lhr-solar/PS-VehicleControlUnit/Hardware/VehicleControlUnitLib/436500428.stp

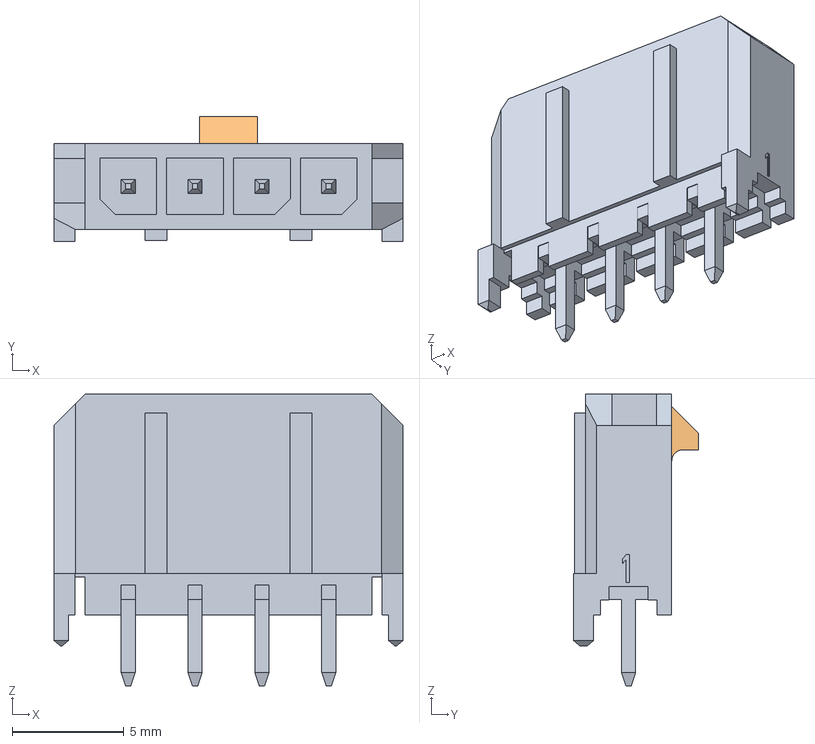
[picture p2: CAD file, 2025-09-12]
Hardware/VehicleControlUnitLib/436500428.stp
15.7 x 5.61 x 13.1 mm
