lhr-solar/PS-VehicleControlUnit/Hardware/VehicleControlUnitLib/436500227.stp

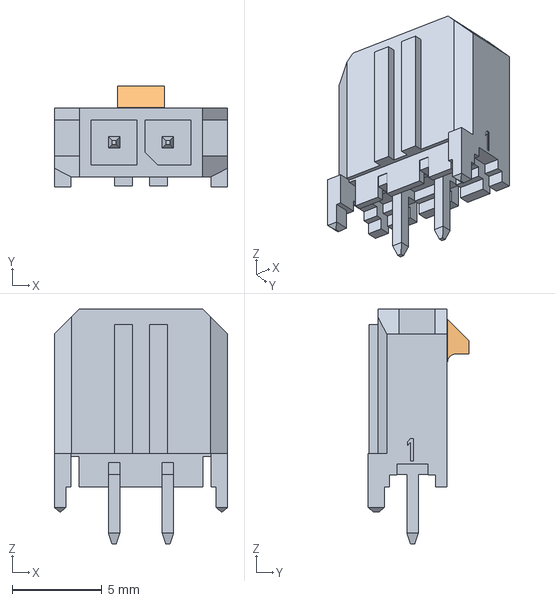
[picture p3: CAD file, 2025-09-12]
Hardware/VehicleControlUnitLib/436500227.stp
9.65 x 5.61 x 13.1 mm
