lhr-solar/PS-VehicleControlUnit/Hardware/ActivePrecharge.kicad_sch

## KiCad design Hardware/ActivePrecharge.kicad_sch (2025-09-12)

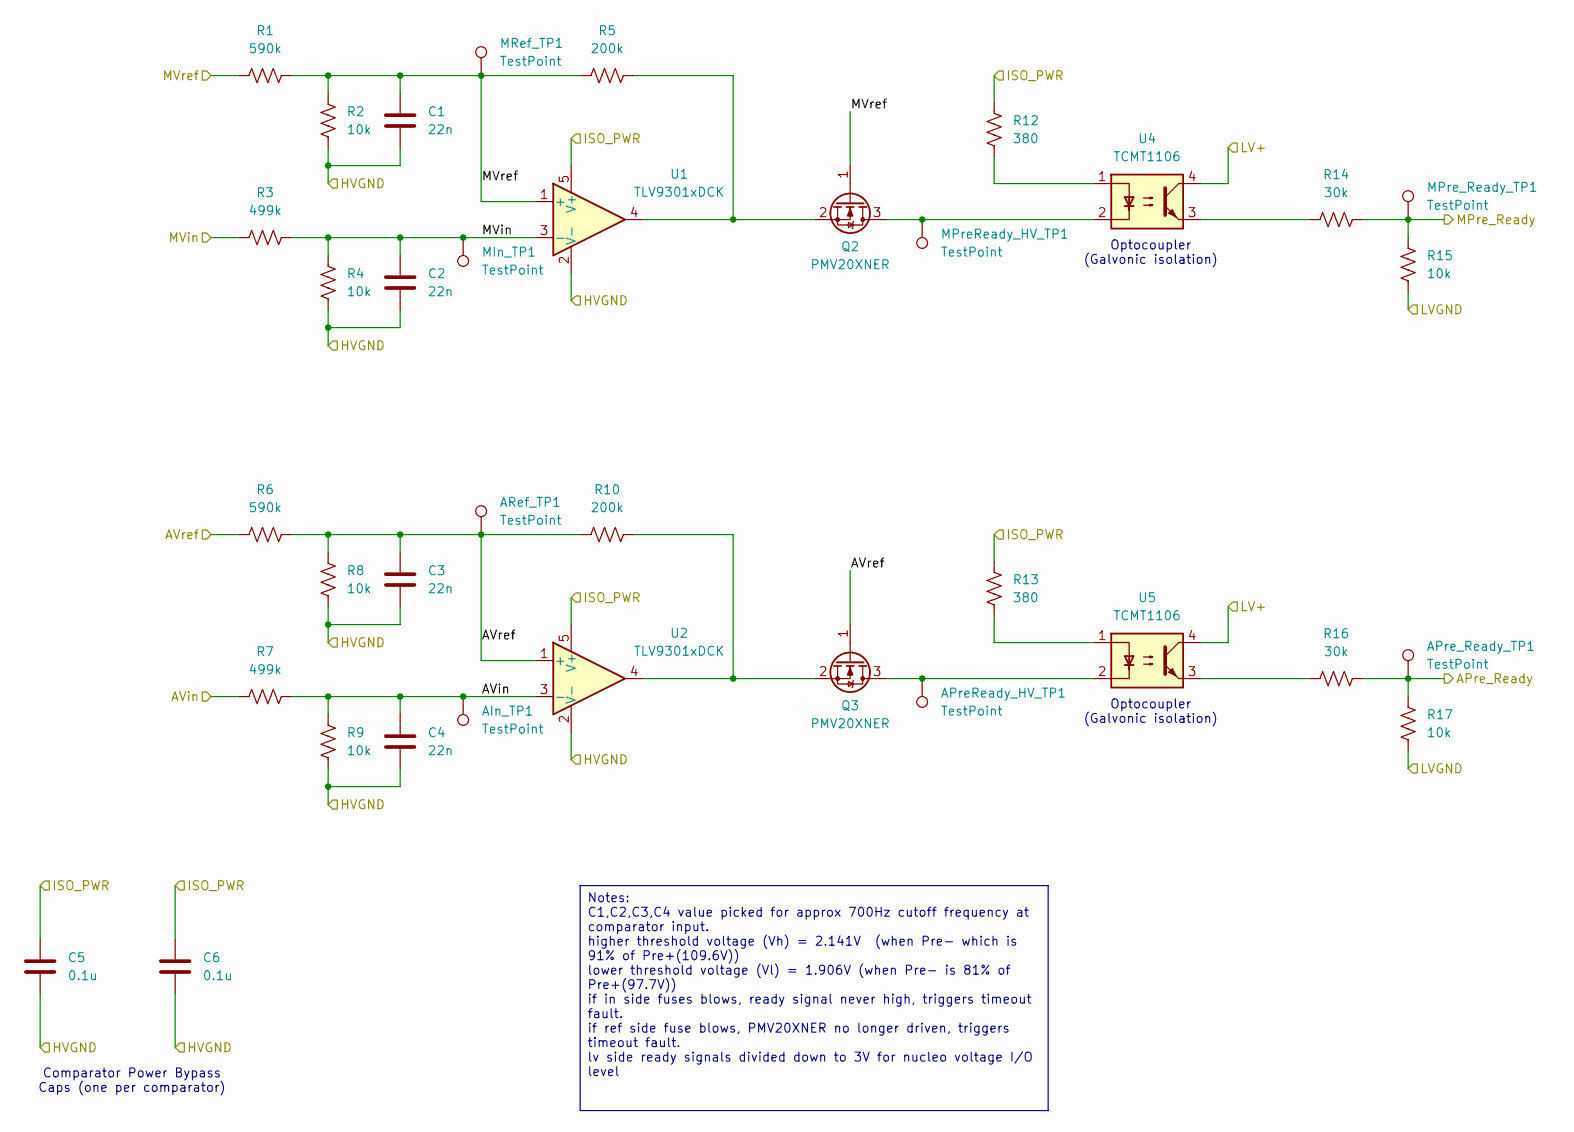
[picture p4: schematic ActivePrecharge.kicad_sch]

Parts:
AIn_TP1: TestPoint
APreReady_HV_TP1: TestPoint
APre_Ready_TP1: TestPoint; TestPoint_HEX_3mmID
ARef_TP1: TestPoint
C1, C2, C3, C4: 22n
C5, C6: 0.1u
MIn_TP1: TestPoint
MPreReady_HV_TP1: TestPoint
MPre_Ready_TP1: TestPoint; TestPoint_HEX_3mmID
MRef_TP1: TestPoint
Q2, Q3: PMV20XNER; SOT-23
R1, R6: 590k
R2, R4, R8, R9: 10k
R3, R7: 499k
R5, R10: 200k
R12, R13: 380; R_0805_2012Metric
R14, R16: 30k; R_0805_2012Metric
R15, R17: 10k; R_0805_2012Metric
U1, U2: TLV9301xDCK; SOT-353_SC-70-5
U4, U5: TCMT1106; SOP-4_4.4x2.6mm_P1.27mm

Connections:
APre_Ready: APre_Ready_TP1.1, R16.2, R17.1
AVin: AIn_TP1.1, C4.1, R7.1, R7.2, R9.2, U2.3 (-)
AVref: ARef_TP1.1, C3.1, Q3.1 (G), R6.1, R6.2, R8.2, R10.2, U2.1 (+)
HVGND: C1.2, C2.2, C3.2, C4.2, C5.2, C6.2, R2.1, R4.1, R8.1, R9.1, U1.2 (V-), U2.2 (V-)
ISO_PWR: C5.1, C6.1, R12.2, R13.2, U1.5 (V+), U2.5 (V+)
LV+: U4.4, U5.4
LVGND: R15.2, R17.2
MPre_Ready: MPre_Ready_TP1.1, R14.2, R15.1
MVin: C2.1, MIn_TP1.1, R3.1, R3.2, R4.2, U1.3 (-)
MVref: C1.1, MRef_TP1.1, Q2.1 (G), R1.1, R1.2, R2.2, R5.2, U1.1 (+)
unnamed: APreReady_HV_TP1.1, Q3.3 (D), U5.2
unnamed: MPreReady_HV_TP1.1, Q2.3 (D), U4.2
unnamed: Q2.2 (S), R5.1, U1.4
unnamed: Q3.2 (S), R10.1, U2.4
unnamed: R12.1, U4.1
unnamed: R13.1, U5.1
unnamed: R14.1, U4.3
unnamed: R16.1, U5.3

Notes on the sheet:
Optocoupler (Galvonic isolation)
Comparator Power Bypass Caps (one per comparator)
Notes: C1,C2,C3,C4 value picked for approx 700Hz cutoff frequency at comparator input. higher threshold voltage (Vh) = 2.141V (when Pre- which is 91% of Pre+(109.6V)) lower threshold voltage (Vl) = 1.906V (when Pre- is 81% of Pre+(97.7V)) if in side fuses blows, ready signal never high, triggers ti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
