lhr-solar/PS-VehicleControlUnit/Hardware/Buttond_LEDs_IO.kicad_sch

## KiCad design Hardware/Buttond_LEDs_IO.kicad_sch (2026-01-13)

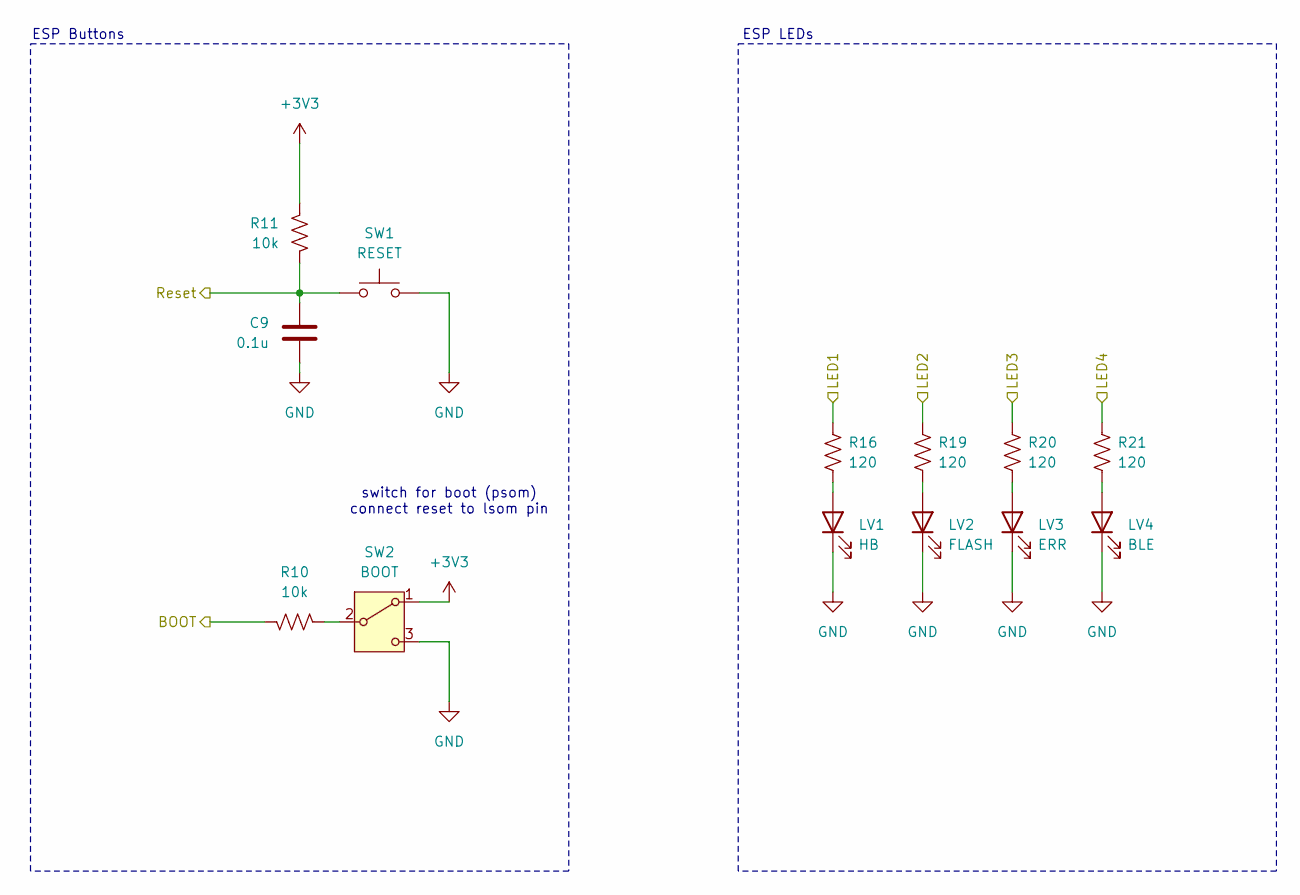
[picture p5: schematic Buttond_LEDs_IO.kicad_sch]

Parts:
C9: 0.1u; C_0603_1608Metric_Pad1.08x0.95mm_HandSolder; Mouser Part Number 963-HMK107B7104KA-T
LV1: HB; LED_0603_1608Metric_Pad1.05x0.95mm_HandSolder
LV2: FLASH; LED_0603_1608Metric_Pad1.05x0.95mm_HandSolder
LV3: ERR; LED_0603_1608Metric_Pad1.05x0.95mm_HandSolder
LV4: BLE; LED_0603_1608Metric_Pad1.05x0.95mm_HandSolder
R10, R11: 10k; R_0603_1608Metric_Pad0.98x0.95mm_HandSolder; Mouser Part Number 71-CRCW060310K0FKEI
R16, R19, R20, R21: 120; R_0603_1608Metric_Pad0.98x0.95mm_HandSolder; Mouser Part Number 71-CRCW0603120RFKEC
SW1: RESET; TL3365AF180QG; Mouser Part Number 667-EVQ-7Q203W
SW2: BOOT; SW_CJS-1200TA; Mouser Part Number 229-CJS-1200TA

Connections:
+3V3: R11.1, SW2.1 (A)
BOOT: R10.1
GND: C9.2, LV1.1 (K), LV2.1 (K), LV3.1 (K), LV4.1 (K), SW1.1 (A), SW1.2 (A), SW2.3 (C)
LED1: R16.1
LED2: R19.1
LED3: R20.1
LED4: R21.1
unnamed: LV1.2 (A), R16.2
unnamed: LV2.2 (A), R19.2
unnamed: LV3.2 (A), R20.2
unnamed: LV4.2 (A), R21.2
unnamed: R10.2, SW2.2 (B)
Reset: C9.1, R11.2, SW1.3 (B), SW1.4 (B)

Notes on the sheet:
switch for boot (psom) connect reset to lsom pin
ESP Buttons
ESP LEDs
