lhr-solar/PS-VehicleControlUnit/Hardware/CAN.kicad_sch

## KiCad design Hardware/CAN.kicad_sch (2025-09-12)

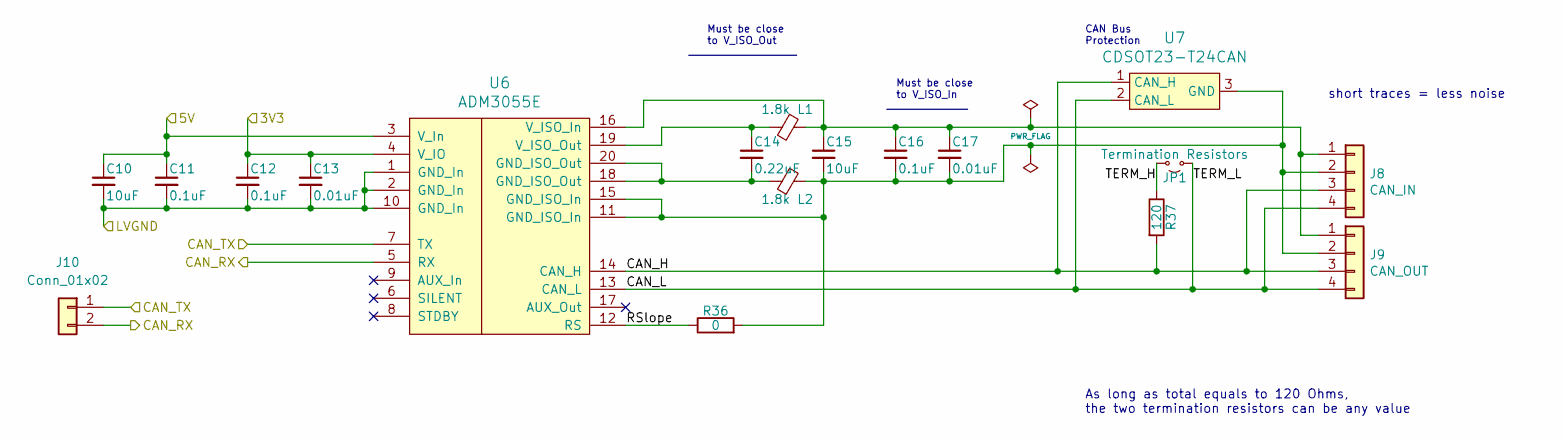
[picture p6: schematic CAN.kicad_sch]

Parts:
C10, C15: 10uF; C_0805_2012Metric; Mouser Part Number 963-TMK212BBJ106MGHT
C11, C12, C16: 0.1uF; C_0805_2012Metric; Mouser Part Number 80-C0805C104M5R
C13, C17: 0.01uF; C_0805_2012Metric
C14: 0.22uF; C_0805_2012Metric; Mouser Part Number 80-C0805C224J1RECTU
J8: CAN_IN; Molex_MicroFit3.0_1x4xP3.00mm_PolarizingPeg_Vertical
J9: CAN_OUT; Molex_MicroFit3.0_1x4xP3.00mm_PolarizingPeg_Vertical
J10: Conn_01x02; PinHeader_1x02_P2.54mm_Vertical
JP1: Termination Resistors; PinHeader_1x02_P2.54mm_Vertical
L1, L2: 1.8k; L_0805_2012Metric; Mouser Part Number 710-742792090
R36: 0; R_0805_2012Metric; Mouser Part Number 71-CRCW08050000Z0EAC
R37: 120; R_0805_2012Metric
U6: ADM3055E; SOIC-20W_7.5x15.4mm_Pitch1.27mm
U7: CDSOT23-T24CAN; SOT-23-3; Mouser Part Number 652-CDSOT23-T24CAN

Connections:
3V3: C12.1, C13.1, U6.4 (V_IO)
5V: C10.1, C11.1, U6.3 (V_In)
CAN_H: J8.3, J9.3, R37.2, U6.14 (CAN_H), U7.1 (CAN_H)
CAN_L: J8.4, J9.4, JP1.1 (A), U6.13 (CAN_L), U7.2 (CAN_L)
CAN_RX: J10.2, U6.5 (RX)
CAN_TX: J10.1, U6.7 (TX)
LVGND: C10.2, C11.2, C12.2, C13.2, U6.1 (GND_In), U6.2 (GND_In), U6.10 (GND_In)
unnamed: C14.1, L1.2, U6.19 (V_ISO_Out)
unnamed: C14.2, L2.2, U6.18 (GND_ISO_Out), U6.20 (GND_ISO_Out)
unnamed: C15.1, C16.1, C17.1, J8.1, J9.1, L1.1, U6.16 (V_ISO_In)
unnamed: C15.2, C16.2, C17.2, J8.2, J9.2, L2.1, R36.2, U6.11 (GND_ISO_In), U6.15 (GND_ISO_In), U7.3 (GND)
RSlope: R36.1, U6.12 (RS)
TERM_H: JP1.2 (B), R37.1

Notes on the sheet:
As long as total equals to 120 Ohms, the two termination resistors can be any value
short traces = less noise
Must be close to V_ISO_Out
Must be close to V_ISO_In
CAN Bus Protection
