lhr-solar/PS-VehicleControlUnit/Hardware/ContactorDriver.kicad_sch

## KiCad design Hardware/ContactorDriver.kicad_sch (2026-01-13)

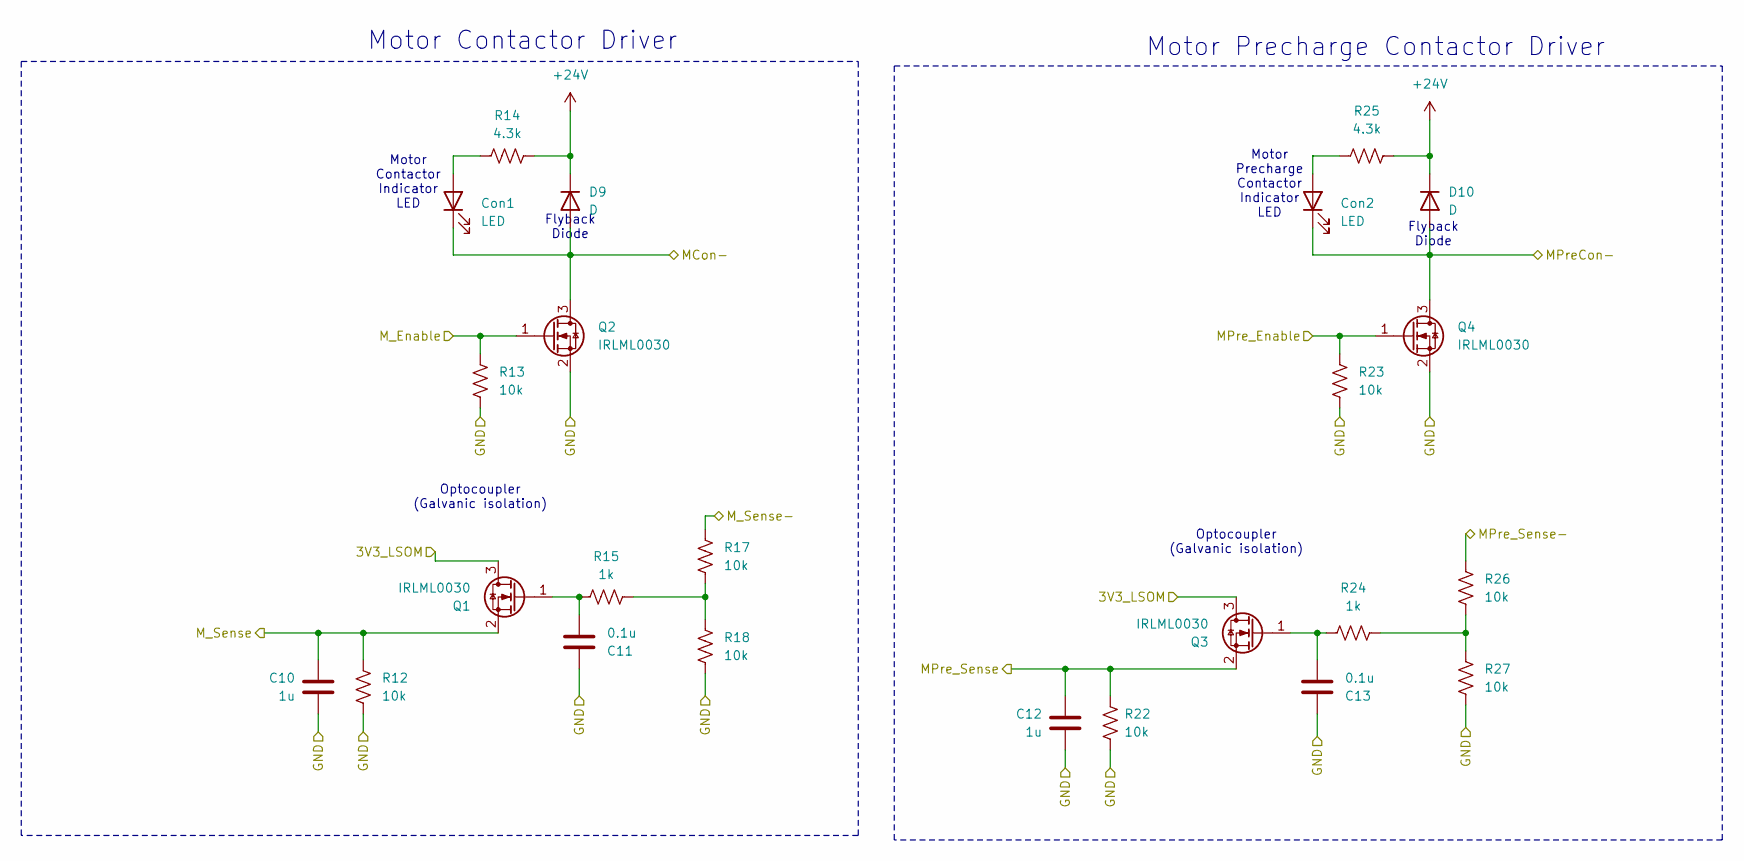
[picture p7: schematic ContactorDriver.kicad_sch]

Parts:
C10, C12: 1u; C_0603_1608Metric_Pad1.08x0.95mm_HandSolder; Mouser Part Number 963-UMK107BJ105KA-T
C11, C13: 0.1u; C_0603_1608Metric_Pad1.08x0.95mm_HandSolder; Mouser Part Number 963-HMK107B7104KA-T
Con1, Con2: LED; LED_0603_1608Metric_Pad1.05x0.95mm_HandSolder
D9, D10: D; SODFL4724X108N; Mouser Part Number 78-VSSAF510HM3/H
Q1, Q2, Q3, Q4: IRLML0030; SOT-23; Mouser Part Number 942-IRLML0030TRPBF
R12, R13, R22, R23: 10k; R_0603_1608Metric_Pad0.98x0.95mm_HandSolder; Mouser Part Number 71-CRCW060310K0FKEI
R14, R25: 4.3k; R_0603_1608Metric_Pad0.98x0.95mm_HandSolder; Mouser Part Number 71-CRCW0603-4.3K-E3
R15, R24: 1k; R_0603_1608Metric_Pad0.98x0.95mm_HandSolder; Mouser Part Number 71-CRCW06031K00FKEI
R17, R18, R26, R27: 10k; R_0603_1608Metric_Pad0.98x0.95mm_HandSolder; Mouser Part Number 71-CRCW06031K00FKEI

Connections:
3V3_LSOM: Q1.3 (D), Q3.3 (D)
+24V: D9.1 (K), D10.1 (K), R14.2, R25.2
GND: C10.1, C11.1, C12.1, C13.1, Q2.2 (S), Q4.2 (S), R12.2, R13.2, R18.2, R22.2, R23.2, R27.2
MCon-: Con1.1 (K), D9.2 (A), Q2.3 (D)
MPreCon-: Con2.1 (K), D10.2 (A), Q4.3 (D)
MPre_Enable: Q4.1 (G), R23.1
MPre_Sense: C12.2, Q3.2 (S), R22.1
MPre_Sense-: R26.1
M_Enable: Q2.1 (G), R13.1
M_Sense: C10.2, Q1.2 (S), R12.1
M_Sense-: R17.1
unnamed: C11.2, Q1.1 (G), R15.2
unnamed: C13.2, Q3.1 (G), R24.2
unnamed: Con1.2 (A), R14.1
unnamed: Con2.2 (A), R25.1
unnamed: R15.1, R17.2, R18.1
unnamed: R24.1, R26.2, R27.1

Notes on the sheet:
Motor Precharge Contactor Driver
Optocoupler (Galvanic isolation)
Motor Contactor Indicator LED
Motor Contactor Driver
Flyback Diode
Motor Precharge Contactor Indicator LED
