lhr-solar/PS-VehicleControlUnit/Hardware/ESP.kicad_sch

## KiCad design Hardware/ESP.kicad_sch (2026-01-13)

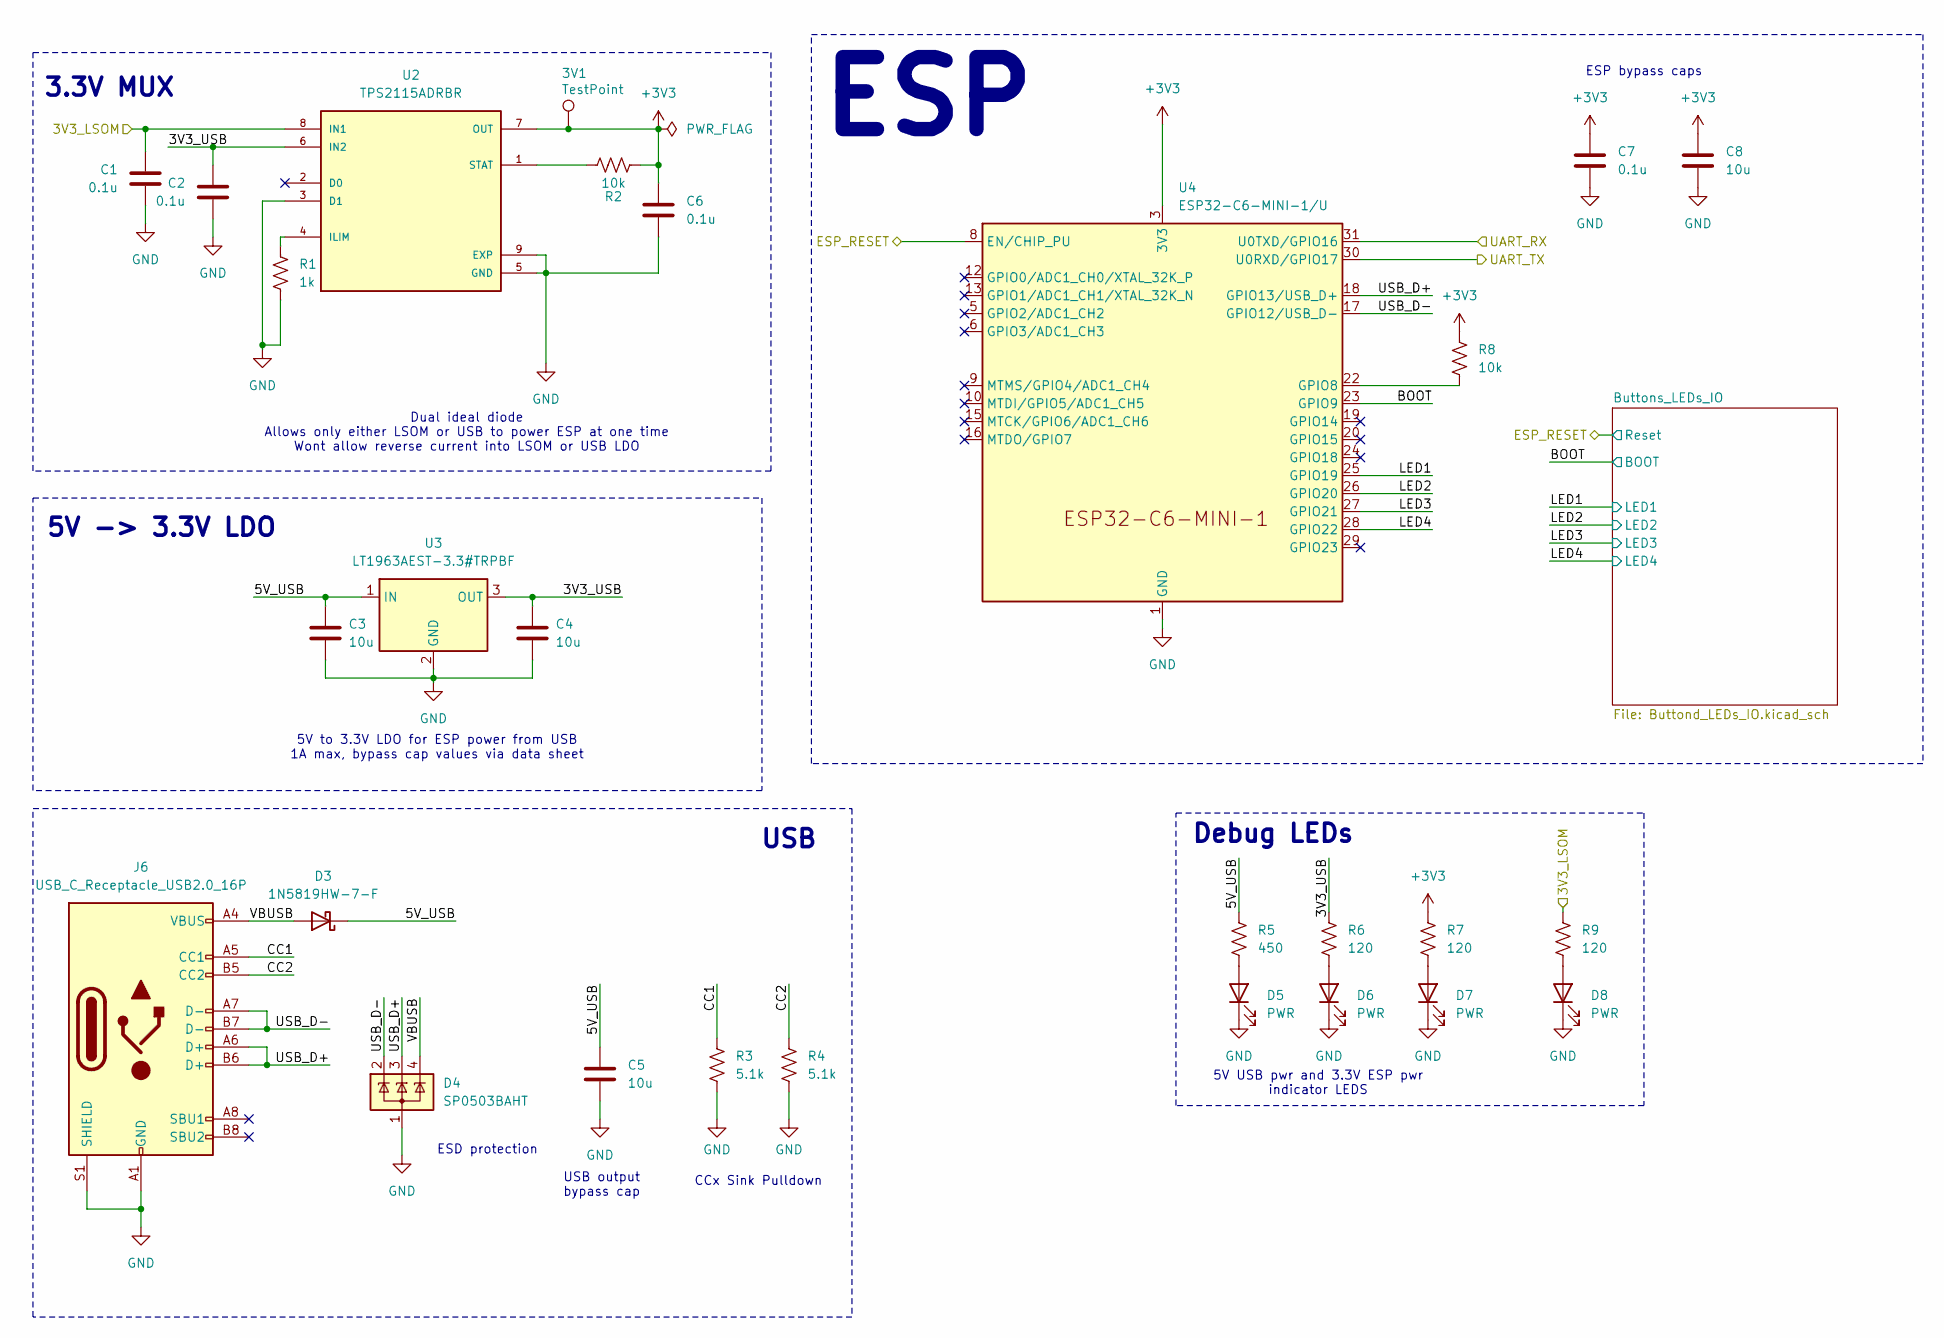
[picture p8: schematic ESP.kicad_sch]

Parts:
3V1: TestPoint; TestPoint_Keystone_5005-5009_Compact
C1, C2, C6, C7: 0.1u; C_0603_1608Metric_Pad1.08x0.95mm_HandSolder; Mouser Part Number 963-HMK107B7104KA-T
C3, C4, C5, C8: 10u; C_0805_2012Metric_Pad1.18x1.45mm_HandSolder; Mouser Part Number 81-GRM21BR61H106KE3K
D3: 1N5819HW-7-F; D_SOD-123; Mouser Part Number 621-1N5819HW-F
D4: SP0503BAHT; SOT-143; Mouser Part Number 576-SP0503BAHTG
D5, D6, D7, D8: PWR; LED_0603_1608Metric_Pad1.05x0.95mm_HandSolder
J6: USB_C_Receptacle_USB2.0_16P; USB_C_Receptacle_GCT_USB4105-xx-A_16P_TopMnt_Horizontal; Mouser Part Number 640-USB4215-03-A
R1: 1k; R_0603_1608Metric_Pad0.98x0.95mm_HandSolder; Mouser Part Number 71-CRCW06031K00FKEI
R2, R8: 10k; R_0603_1608Metric_Pad0.98x0.95mm_HandSolder; Mouser Part Number 71-CRCW060310K0FKEI
R3, R4: 5.1k; R_0603_1608Metric_Pad0.98x0.95mm_HandSolder; Mouser Part Number 71-CRCW06035K10FKEC
R5: 450; R_0603_1608Metric_Pad0.98x0.95mm_HandSolder; Mouser Part Number 71-CRCW1206-470-E3
R6, R7, R9: 120; R_0603_1608Metric_Pad0.98x0.95mm_HandSolder; Mouser Part Number 71-CRCW0603120RFKEC
U2: TPS2115ADRBR; SON65P300X300X100-9N; Mouser Part Number 595-TPS2115ADRBR
U3: LT1963AEST-3.3#TRPBF; SOT-223-3_TabPin2; Mouser Part Number 584-1963AEST-3.3TPF
U4: ESP32-C6-MINI-1/U; ESP32-C6-MINI-1; Mouser Part Number 356-ESP32-C6MINI1UN4

Connections:
3V3_LSOM: C1.1, R9.1, U2.8 (IN1)
3V3_USB: C2.1, C4.1, R6.1, U2.6 (IN2), U3.3 (OUT)
5V_USB: C3.1, C5.1, D3.1 (K), R5.1, U3.1 (IN)
+3V3: 3V1.1, C6.1, C7.1, C8.1, R2.1, R7.1, R8.2, U2.7 (OUT), U4.3 (3V3)
BOOT: U4.23 (GPIO9)
CC1: J6.A5 (CC1), R3.1
CC2: J6.B5 (CC2), R4.1
ESP_RESET: U4.8 (EN/CHIP_PU)
GND: C1.2, C2.2, C3.2, C4.2, C5.2, C6.2, C7.2, C8.2, D4.1 (A), D5.1 (K), D6.1 (K), D7.1 (K), D8.1 (K), J6.A1 (GND), J6.A12 (GND), J6.B1 (GND), J6.B12 (GND), J6.S1 (SHIELD), J6.S2 (Shield), J6.S3 (Shield), J6.S4 (Shield), R1.2, R3.2, R4.2, U2.3 (D1), U2.5 (GND), U2.9 (EXP), U3.2 (GND), U4.1 (GND), U4.2 (GND), U4.11 (GND), U4.14 (GND), U4.36 (GND), U4.37 (GND), U4.38 (GND), U4.39 (GND), U4.40 (GND), U4.41 (GND), U4.42 (GND), U4.43 (GND), U4.44 (GND), U4.45 (GND), U4.46 (GND), U4.47 (GND), U4.48 (GND), U4.49 (GND), U4.50 (GND), U4.51 (GND), U4.52 (GND), U4.53 (GND)
LED1: U4.25 (GPIO19)
LED2: U4.26 (GPIO20)
LED3: U4.27 (GPIO21)
LED4: U4.28 (GPIO22)
unnamed: D5.2 (A), R5.2
unnamed: D6.2 (A), R6.2
unnamed: D7.2 (A), R7.2
unnamed: D8.2 (A), R9.2
unnamed: R1.1, U2.4 (ILIM)
unnamed: R2.2, U2.1 (STAT)
unnamed: R8.1, U4.22 (GPIO8)
UART_RX: U4.31 (U0TXD/GPIO16)
UART_TX: U4.30 (U0RXD/GPIO17)
USB_D+: D4.3 (K), J6.A6 (D+), J6.B6 (D+), U4.18 (GPIO13/USB_D+)
USB_D-: D4.2 (K), J6.A7 (D-), J6.B7 (D-), U4.17 (GPIO12/USB_D-)
VBUSB: D3.2 (A), D4.4 (K), J6.A4 (VBUS), J6.A9 (VBUS), J6.B4 (VBUS), J6.B9 (VBUS)

Notes on the sheet:
3.3V MUX
Dual ideal diode Allows only either LSOM or USB to power ESP at one time Wont allow reverse current into LSOM or USB LDO
5V USB pwr and 3.3V ESP pwr indicator LEDS
USB output bypass cap
ESP
ESD protection
CCx Sink Pulldown
5V -> 3.3V LDO
USB
ESP bypass caps
5V to 3.3V LDO for ESP power from USB 1A max, bypass cap values via data sheet
Debug LEDs
