lhr-solar/PS-VehicleControlUnit/Hardware/HVArchitecture.kicad_sch

## KiCad design Hardware/HVArchitecture.kicad_sch (2025-09-12)

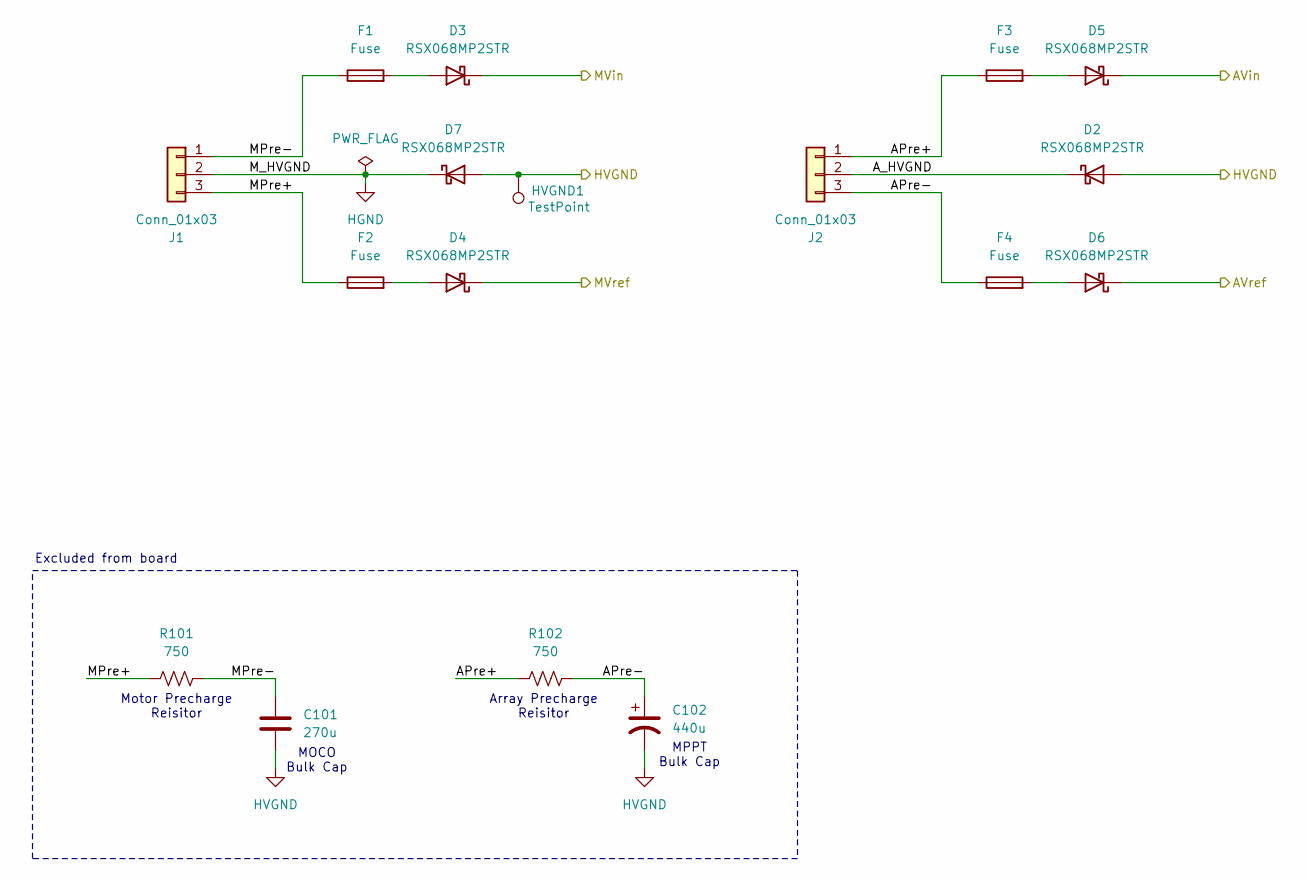
[picture p9: schematic HVArchitecture.kicad_sch]

Parts:
C101: 270u
C102: 440u
D2, D3, D4, D5, D6, D7: RSX068MP2STR; D_SOD-123F
F1, F2, F3, F4: Fuse; Fuseholder_Blade_Mini_Keystone_3568
HVGND1: TestPoint; TestPoint_HEX_3mmID
J1, J2: Conn_01x03; Molex_MicroFit3.0_1x3xP3.00mm_PolarizingPeg_Vertical
R101, R102: 750

Connections:
APre+: F3.1, J2.1, R102.1
APre-: C102.1, F4.1, J2.3, R102.2
AVin: D5.1 (K)
AVref: D6.1 (K)
A_HVGND: D2.1 (K), J2.2
HGND: D7.1 (K), J1.2
HVGND: C101.2, C102.2, D2.2 (A), D7.2 (A), HVGND1.1
MPre+: F2.1, J1.3, R101.1
MPre-: C101.1, F1.1, J1.1, R101.2
MVin: D3.1 (K)
MVref: D4.1 (K)
unnamed: D3.2 (A), F1.2
unnamed: D4.2 (A), F2.2
unnamed: D5.2 (A), F3.2
unnamed: D6.2 (A), F4.2

Notes on the sheet:
Array Precharge Reisitor
MOCO Bulk Cap
MPPT Bulk Cap
Motor Precharge Reisitor
Excluded from board
