lhr-solar/PS-VehicleControlUnit/Hardware/Power.kicad_sch

## KiCad design Hardware/Power.kicad_sch (2026-01-13)

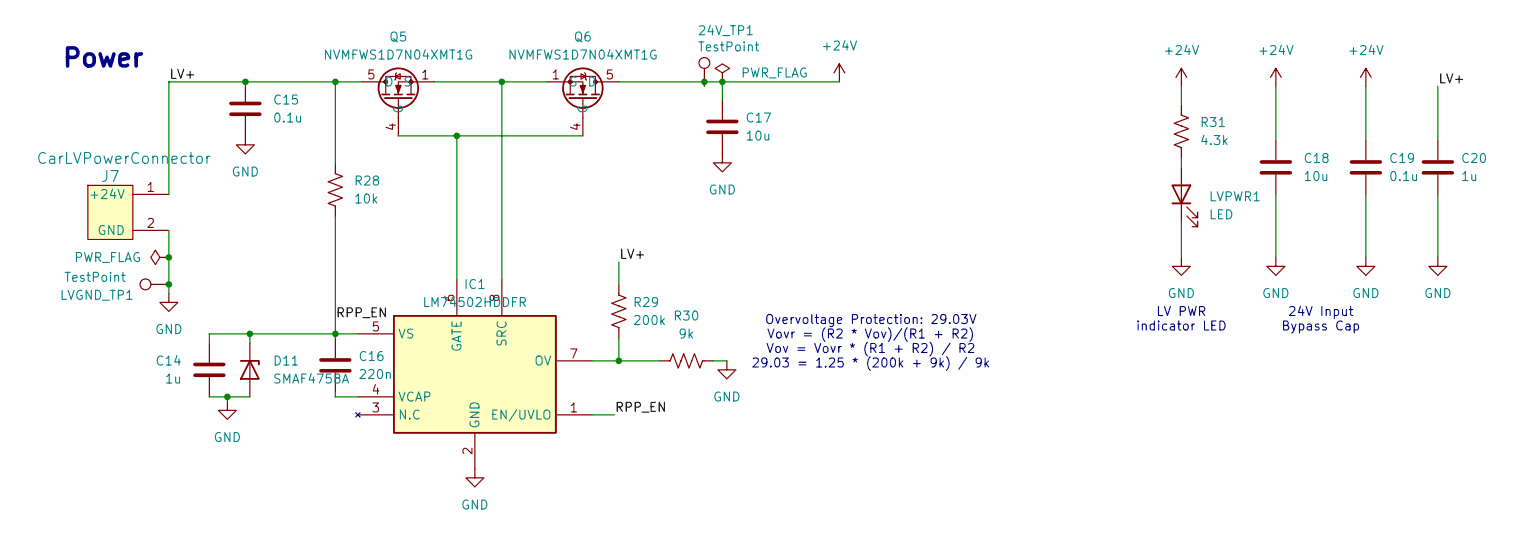
[picture p10: schematic Power.kicad_sch]

Parts:
24V_TP1: TestPoint; TestPoint_Keystone_5005-5009_Compact
C14: 1u; C_0603_1608Metric_Pad1.08x0.95mm_HandSolder; Mouser Part Number 963-UMK107BJ105KA-T
C15, C19: 0.1u; C_0603_1608Metric_Pad1.08x0.95mm_HandSolder; Mouser Part Number 963-HMK107B7104KA-T
C16: 220n; C_0603_1608Metric_Pad1.08x0.95mm_HandSolder; Mouser Part Number 963-MSASU168SB7224KT
C17, C18: 10u; C_0805_2012Metric_Pad1.18x1.45mm_HandSolder; Mouser Part Number 81-GRM21BR61H106KE3K
C20: 1u; C_0603_1608Metric_Pad1.08x0.95mm_HandSolder; Mouser Part Number 963-HMK107B7104KA-T
D11: SMAF4758A; SODFL5026X125N; Mouser Part Number 833-SMAF4758A-TP
IC1: LM74502HDDFR; SOT65P280X110-8N; Mouser Part Number 595-LM74502HDDFR
J7: CarLVPowerConnector; Molex_Nano-Fit_105309-xx02_1x02_P2.50mm_Vertical; Mouser Part Number 538-105309-1102
LVGND_TP1: TestPoint; TestPoint_Keystone_5005-5009_Compact
LVPWR1: LED; LED_0603_1608Metric_Pad1.05x0.95mm_HandSolder
Q5, Q6: NVMFWS1D7N04XMT1G; NVMFWS3D0P04M8LT1G
R28: 10k; R_0603_1608Metric_Pad0.98x0.95mm_HandSolder; Mouser Part Number 71-CRCW060310K0FKEI
R29: 200k; R_0603_1608Metric_Pad0.98x0.95mm_HandSolder; Mouser Part Number 594-MCT06030C2003FP5
R30: 9k; R_0603_1608Metric_Pad0.98x0.95mm_HandSolder; Mouser Part Number 594-MCT06030C9091FP5
R31: 4.3k; R_0603_1608Metric_Pad0.98x0.95mm_HandSolder; Mouser Part Number 71-CRCW0603-4.3K-E3

Connections:
+24V: 24V_TP1.1, C17.1, C18.1, C19.1, Q6.5 (D), Q6.6 (D), Q6.7 (D), Q6.8 (D), Q6.9 (D), R31.1
GND: C14.1, C15.2, C17.2, C18.2, C19.2, C20.2, D11.2 (A), IC1.2 (GND), J7.2 (GND), LVGND_TP1.1, LVPWR1.1 (K), R30.2
LV+: C15.1, C20.1, J7.1 (+24V), Q5.5 (D), Q5.6 (D), Q5.7 (D), Q5.8 (D), Q5.9 (D), R28.1, R29.1
unnamed: C16.2, IC1.4 (VCAP)
unnamed: IC1.6 (GATE), Q5.4 (G), Q6.4 (G)
unnamed: IC1.7 (OV), R29.2, R30.1
unnamed: IC1.8 (SRC), Q5.1 (S), Q5.2 (S), Q5.3 (S), Q6.1 (S), Q6.2 (S), Q6.3 (S)
unnamed: LVPWR1.2 (A), R31.2
RPP_EN: C14.2, C16.1, D11.1 (K), IC1.1 (EN/UVLO), IC1.5 (VS), R28.2

Notes on the sheet:
Overvoltage Protection: 29.03V Vovr = (R2 * Vov)/(R1 + R2) Vov = Vovr * (R1 + R2) / R2 29.03 = 1.25 * (200k + 9k) / 9k
LV PWR indicator LED
24V Input Bypass Cap
Power
