lhr-solar/PS-VehicleControlUnit/Hardware/PowerMisc.kicad_sch

## KiCad design Hardware/PowerMisc.kicad_sch (2025-09-12)

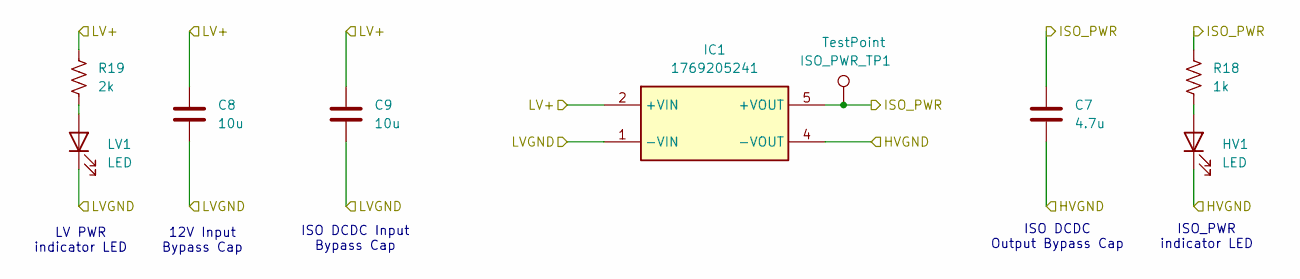
[picture p11: schematic PowerMisc.kicad_sch]

Parts:
C7: 4.7u; C_0805_2012Metric
C8, C9: 10u; C_0805_2012Metric
HV1: LED; LED_0805_2012Metric
IC1: 1769205241; Manufacturer_Part_Number 1769205241
ISO_PWR_TP1: TestPoint; TestPoint_HEX_3mmID
LV1: LED; LED_0805_2012Metric
R18: 1k; R_0805_2012Metric
R19: 2k; R_0805_2012Metric

Connections:
HVGND: C7.2, HV1.1 (K), IC1.4 (-VOUT)
ISO_PWR: C7.1, IC1.5 (+VOUT), ISO_PWR_TP1.1, R18.1
LV+: C8.1, C9.1, IC1.2 (+VIN), R19.1
LVGND: C8.2, C9.2, IC1.1 (-VIN), LV1.1 (K)
unnamed: HV1.2 (A), R18.2
unnamed: LV1.2 (A), R19.2

Notes on the sheet:
12V Input Bypass Cap
LV PWR indicator LED
ISO DCDC Input Bypass Cap
ISO_PWR indicator LED
ISO DCDC Output Bypass Cap
