lhr-solar/PS-VehicleControlUnit/Hardware/Status_LEDs.kicad_sch

## KiCad design Hardware/Status_LEDs.kicad_sch (2026-01-13)

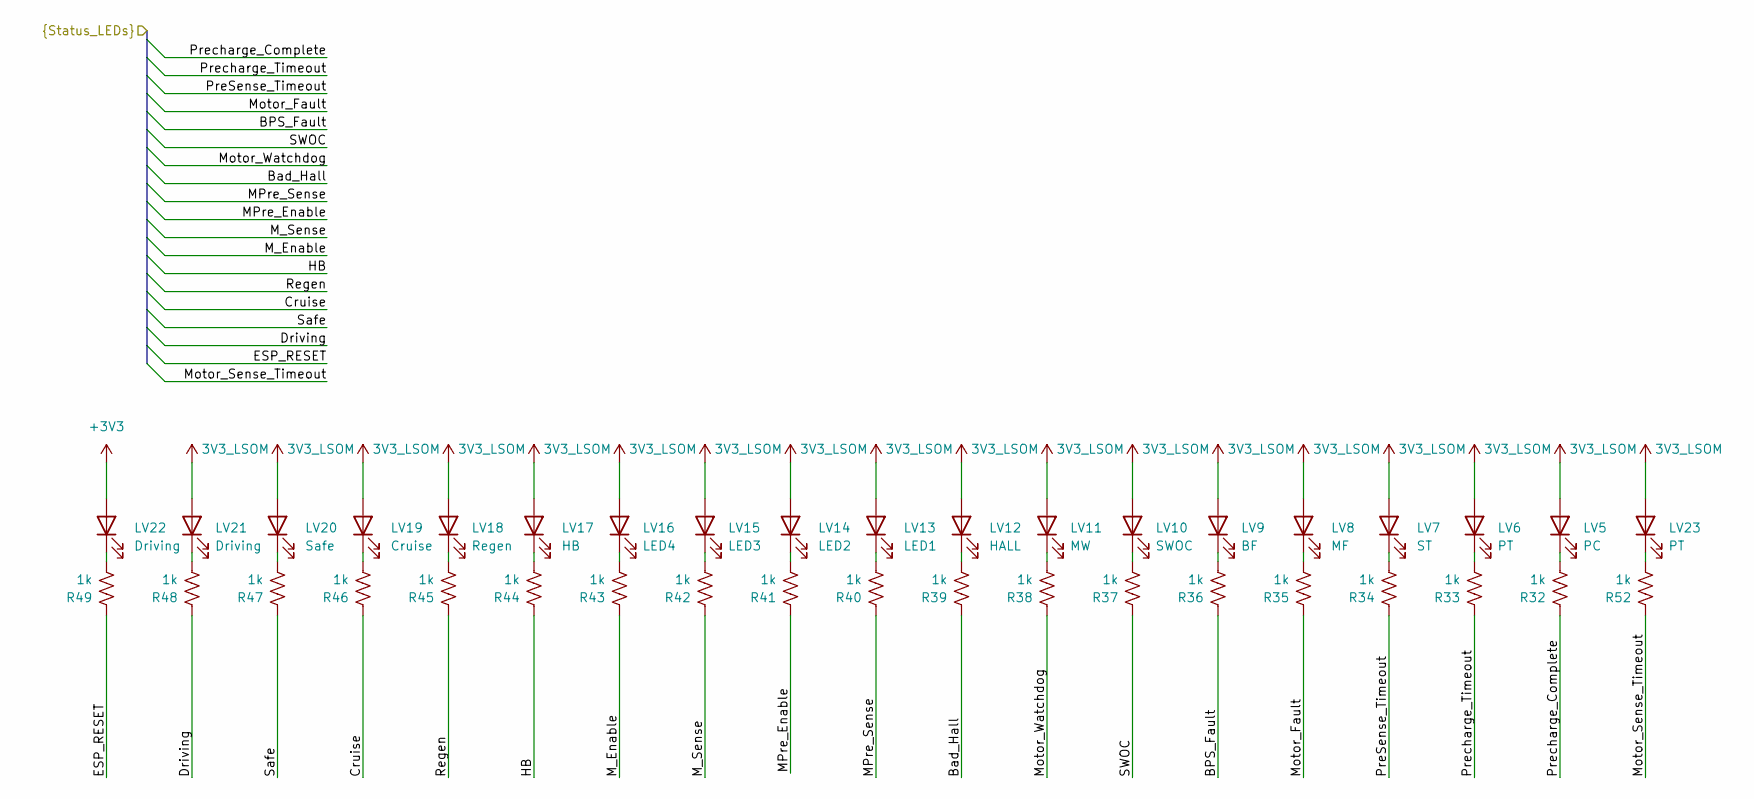
[picture p12: schematic Status_LEDs.kicad_sch]

Parts:
LV5: PC; LED_0603_1608Metric_Pad1.05x0.95mm_HandSolder
LV6, LV23: PT; LED_0603_1608Metric_Pad1.05x0.95mm_HandSolder
LV7: ST; LED_0603_1608Metric_Pad1.05x0.95mm_HandSolder
LV8: MF; LED_0603_1608Metric_Pad1.05x0.95mm_HandSolder
LV9: BF; LED_0603_1608Metric_Pad1.05x0.95mm_HandSolder
LV10: SWOC; LED_0603_1608Metric_Pad1.05x0.95mm_HandSolder
LV11: MW; LED_0603_1608Metric_Pad1.05x0.95mm_HandSolder
LV12: HALL; LED_0603_1608Metric_Pad1.05x0.95mm_HandSolder
LV13: LED1; LED_0603_1608Metric_Pad1.05x0.95mm_HandSolder
LV14: LED2; LED_0603_1608Metric_Pad1.05x0.95mm_HandSolder
LV15: LED3; LED_0603_1608Metric_Pad1.05x0.95mm_HandSolder
LV16: LED4; LED_0603_1608Metric_Pad1.05x0.95mm_HandSolder
LV17: HB; LED_0603_1608Metric_Pad1.05x0.95mm_HandSolder
LV18: Regen; LED_0603_1608Metric_Pad1.05x0.95mm_HandSolder
LV19: Cruise; LED_0603_1608Metric_Pad1.05x0.95mm_HandSolder
LV20: Safe; LED_0603_1608Metric_Pad1.05x0.95mm_HandSolder
LV21, LV22: Driving; LED_0603_1608Metric_Pad1.05x0.95mm_HandSolder
R32, R33, R34, R35, R36, R37, R38, R39, R40, R41, R42, R43, R44, R45, R46, R47, R48, R49, R52: 1k; R_0603_1608Metric_Pad0.98x0.95mm_HandSolder; Mouser Part Number 71-CRCW0603120RFKEC

Connections:
3V3_LSOM: LV5.2 (A), LV6.2 (A), LV7.2 (A), LV8.2 (A), LV9.2 (A), LV10.2 (A), LV11.2 (A), LV12.2 (A), LV13.2 (A), LV14.2 (A), LV15.2 (A), LV16.2 (A), LV17.2 (A), LV18.2 (A), LV19.2 (A), LV20.2 (A), LV21.2 (A), LV23.2 (A)
+3V3: LV22.2 (A)
BPS_Fault: R36.1
Bad_Hall: R39.1
Cruise: R46.1
Driving: R48.1
ESP_RESET: R49.1
HB: R44.1
MPre_Enable: R41.1
MPre_Sense: R40.1
M_Enable: R43.1
M_Sense: R42.1
Motor_Fault: R35.1
Motor_Sense_Timeout: R52.1
Motor_Watchdog: R38.1
unnamed: LV5.1 (K), R32.2
unnamed: LV6.1 (K), R33.2
unnamed: LV7.1 (K), R34.2
unnamed: LV8.1 (K), R35.2
unnamed: LV9.1 (K), R36.2
unnamed: LV10.1 (K), R37.2
unnamed: LV11.1 (K), R38.2
unnamed: LV12.1 (K), R39.2
unnamed: LV13.1 (K), R40.2
unnamed: LV14.1 (K), R41.2
unnamed: LV15.1 (K), R42.2
unnamed: LV16.1 (K), R43.2
unnamed: LV17.1 (K), R44.2
unnamed: LV18.1 (K), R45.2
unnamed: LV19.1 (K), R46.2
unnamed: LV20.1 (K), R47.2
unnamed: LV21.1 (K), R48.2
unnamed: LV22.1 (K), R49.2
unnamed: LV23.1 (K), R52.2
PreSense_Timeout: R34.1
Precharge_Complete: R32.1
Precharge_Timeout: R33.1
Regen: R45.1
SWOC: R37.1
Safe: R47.1
