lhr-solar/PS-VehicleControlUnit/Hardware/VehicleControlUnit.kicad_sch

## KiCad design Hardware/VehicleControlUnit.kicad_sch (2026-01-13)

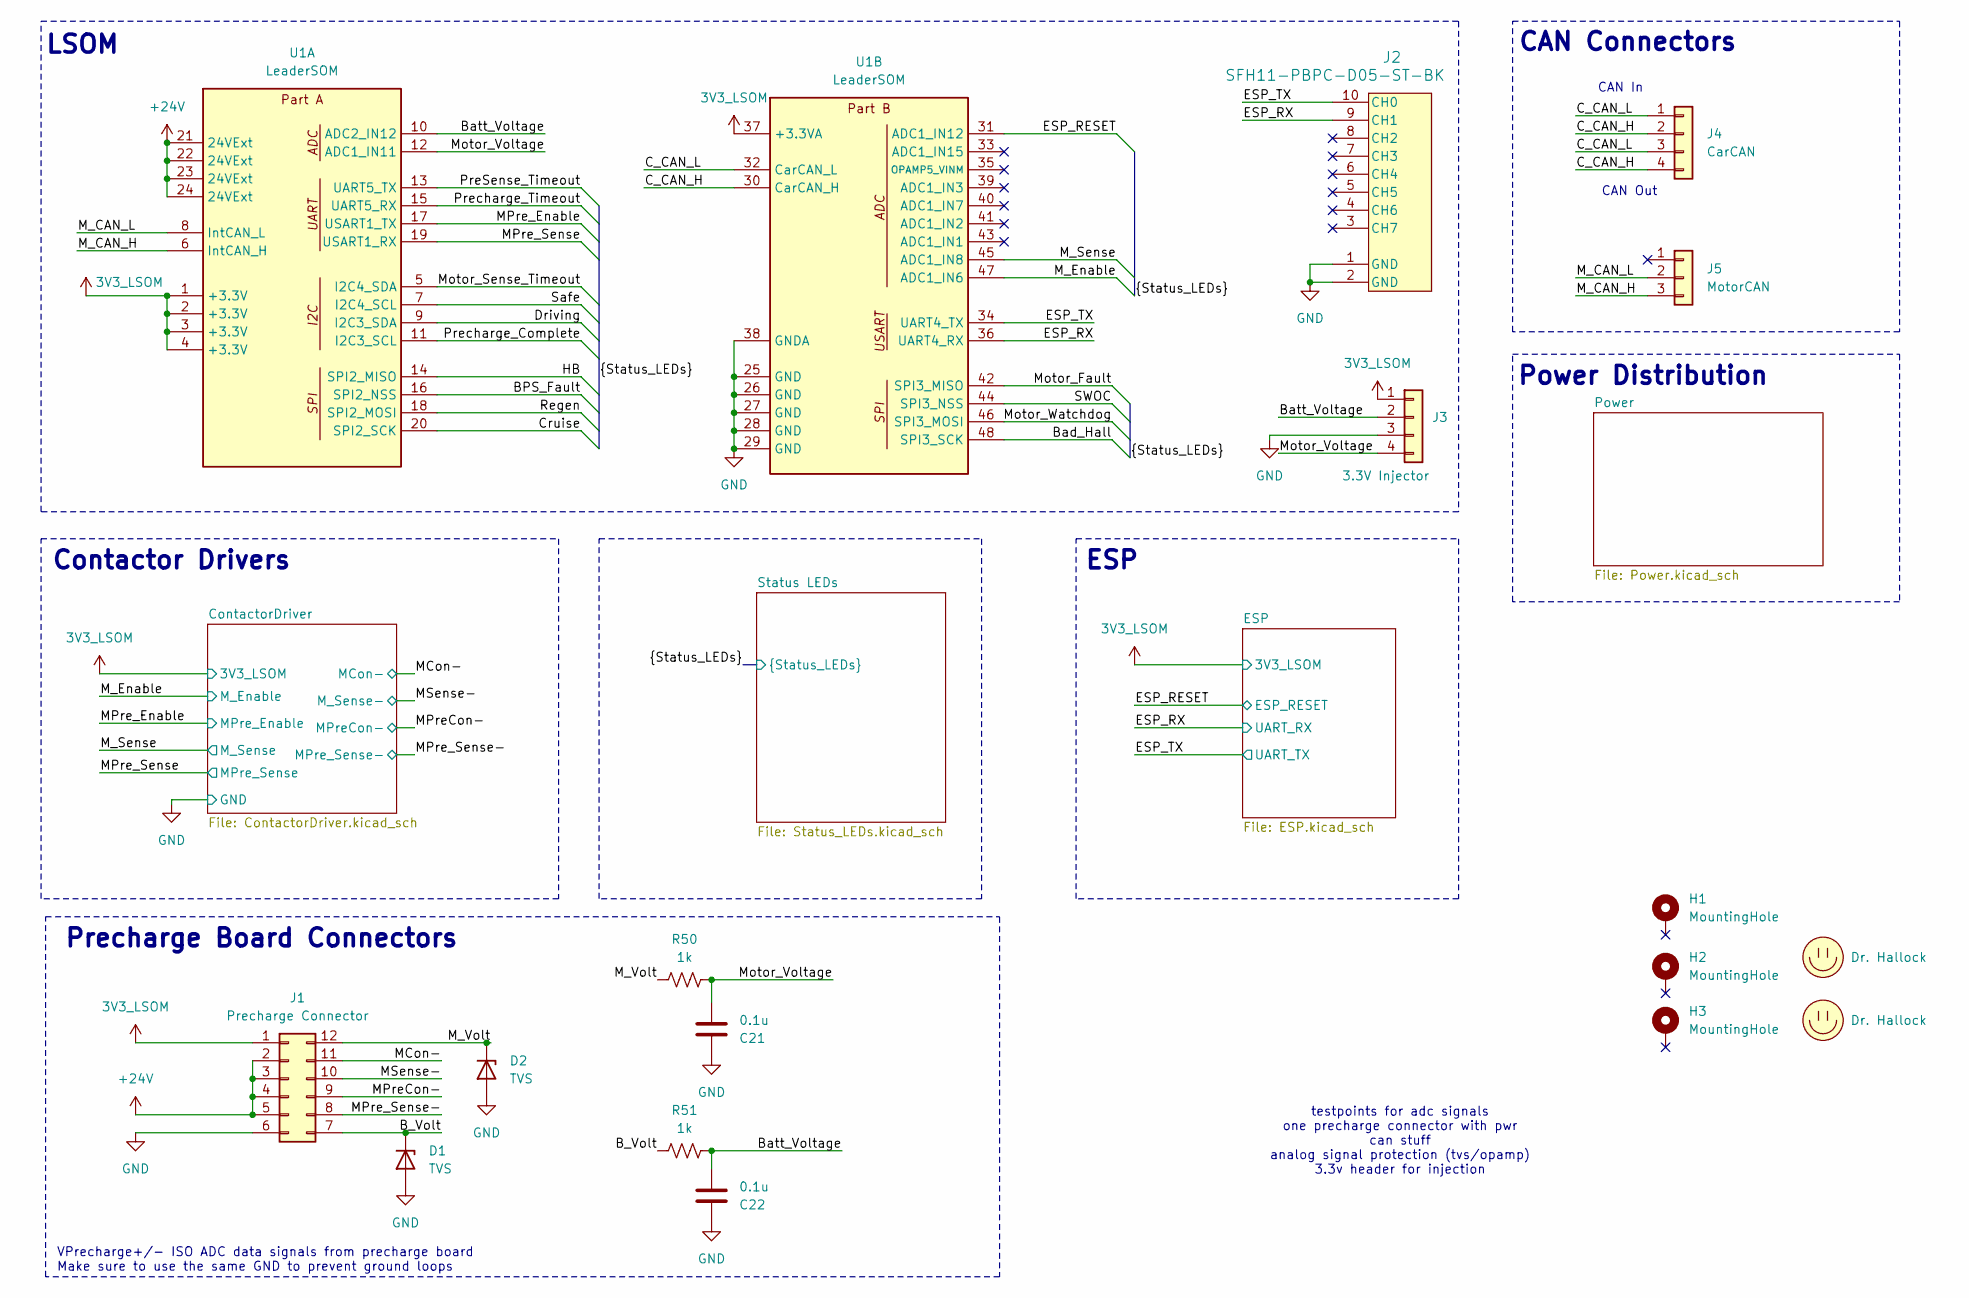
[picture p13: schematic VehicleControlUnit.kicad_sch]

Parts:
C21, C22: 0.1u; C_0603_1608Metric_Pad1.08x0.95mm_HandSolder; Mouser Part Number 963-HMK107B7104KA-T
D1, D2: TVS; D_SOD-123F; Mouser Part Number 576-SMF3.3
H1, H2, H3: MountingHole; MountingHole_3.2mm_M3_Pad_TopBottom
J1: Precharge Connector; Molex_Nano-Fit_105310-xx12_2x06_P2.50mm_Vertical; Mouser Part Number 538-105310-1112
J2: SFH11-PBPC-D05-ST-BK; CONN_SFH11-xxxC-D05-ST-XX_SUL
J3: 3.3V Injector; PinHeader_1x04_P2.54mm_Vertical
J4: CarCAN; Molex_Nano-Fit_105309-xx04_1x04_P2.50mm_Vertical; Mouser Part Number 538-105309-1104
J5: MotorCAN; Molex_Nano-Fit_105309-xx03_1x03_P2.50mm_Vertical; Mouser Part Number 538-105309-1103
LOGO1: Dr. Hallock; Hallock_Image_Tiny
LOGO2: Dr. Hallock; LHRs_LOGO
R50, R51: 1k; R_0603_1608Metric_Pad0.98x0.95mm_HandSolder; Mouser Part Number 71-CRCW06031K00FKEI
U1: LeaderSOM

Connections:
3V3_LSOM: J1.1, J3.1, U1.1 (+3.3V), U1.2 (+3.3V), U1.3 (+3.3V), U1.4 (+3.3V), U1.37 (+3.3VA)
+24V: J1.2, J1.3, J1.4, J1.5, U1.21 (24VExt), U1.22 (24VExt), U1.23 (24VExt), U1.24 (24VExt)
BPS_Fault: U1.16 (SPI2_NSS)
B_Volt: D1.1 (K), J1.7, R51.2
Bad_Hall: U1.48 (SPI3_SCK)
Batt_Voltage: C22.2, J3.2, R51.1, U1.10 (ADC2_IN12)
C_CAN_H: J4.2, J4.4, U1.30 (CarCAN_H)
C_CAN_L: J4.1, J4.3, U1.32 (CarCAN_L)
Cruise: U1.20 (SPI2_SCK)
Driving: U1.9 (I2C3_SDA)
ESP_RESET: U1.31 (ADC1_IN12)
ESP_RX: J2.9 (CH1), U1.36 (UART4_RX)
ESP_TX: J2.10 (CH0), U1.34 (UART4_TX)
GND: C21.1, C22.1, D1.2 (A), D2.2 (A), J1.6, J2.1 (GND), J2.2 (GND), J3.3, U1.25 (GND), U1.26 (GND), U1.27 (GND), U1.28 (GND), U1.29 (GND), U1.38 (GNDA)
HB: U1.14 (SPI2_MISO)
MCon-: J1.11
MPreCon-: J1.9
MPre_Enable: U1.17 (USART1_TX)
MPre_Sense: U1.19 (USART1_RX)
MPre_Sense-: J1.8
MSense-: J1.10
M_CAN_H: J5.3, U1.6 (IntCAN_H)
M_CAN_L: J5.2, U1.8 (IntCAN_L)
M_Enable: U1.47 (ADC1_IN6)
M_Sense: U1.45 (ADC1_IN8)
M_Volt: D2.1 (K), J1.12, R50.2
Motor_Fault: U1.42 (SPI3_MISO)
Motor_Sense_Timeout: U1.5 (I2C4_SDA)
Motor_Voltage: C21.2, J3.4, R50.1, U1.12 (ADC1_IN11)
Motor_Watchdog: U1.46 (SPI3_MOSI)
PreSense_Timeout: U1.13 (UART5_TX)
Precharge_Complete: U1.11 (I2C3_SCL)
Precharge_Timeout: U1.15 (UART5_RX)
Regen: U1.18 (SPI2_MOSI)
SWOC: U1.44 (SPI3_NSS)
Safe: U1.7 (I2C4_SCL)

Notes on the sheet:
Precharge Board Connectors
CAN In
Contactor Drivers
testpoints for adc signals one precharge connector with pwr can stuff analog signal protection (tvs/opamp) 3.3v header for injection
Power Distribution
VPrecharge+/- ISO ADC data signals from precharge board Make sure to use the same GND to prevent ground loops
LSOM
ESP
CAN Out
CAN Connectors
