lhr-solar/PS-VehicleControlUnit/Firmware/VehicleControlUnit.ioc

Mcu.UserName=STM32G473RETx
PA10.Signal=GPIO_Output
PA11.Signal=FDCAN1_RX
PA12.Signal=FDCAN1_TX
PA13.Signal=SYS_JTMS-SWDIO
PA14.Signal=SYS_JTCK-SWCLK
PA15.Signal=FDCAN3_TX
PA3.Signal=GPIO_Input
PA4.Signal=SPI1_NSS
PA5.Signal=SPI1_SCK
PA6.Signal=SPI1_MISO
PA7.Signal=SPI1_MOSI
PA8.Signal=FDCAN3_RX
PA9.Signal=GPIO_Input
PB10.Signal=USART3_TX
PB11.Signal=USART3_RX
PB12.Signal=ADC1_IN11
PB13.Signal=GPIO_Output
PB14.Signal=GPIO_Output
PB15.Signal=GPIO_Output
PB2.Signal=ADC2_IN12
PB3.Signal=GPIO_Output
PB4.Signal=GPIO_Output
PB5.Signal=GPIO_Output
PB6.Signal=GPIO_Output
PB7.Signal=SYS_PVD_IN
PB8-BOOT0.Signal=GPXTI8
PB9.Signal=GPIO_Output
PC0.Signal=GPXTI0
PC1.Signal=GPIO_Input
PC10.Signal=UART4_TX
PC11.Signal=UART4_RX
PC12.Signal=GPIO_Output
PC3.Signal=GPIO_Output
PC4.Signal=GPIO_Input
PC5.Signal=GPIO_Output
PC6.Signal=GPIO_Output
PC7.Signal=GPIO_Output
PC8.Signal=GPIO_Output
PC9.Signal=GPIO_Output
PD2.Signal=GPIO_Output
PF0-OSC_IN.Signal=RCC_OSC_IN
PF1-OSC_OUT.Signal=RCC_OSC_OUT
PG10-NRST.Signal=RCC_MCO
