lhr-solar/PS-VehicleControlUnit/Firmware/config/Inc/pinDefs.h

#pragma once

#include "stm32xx_hal.h"

#define HB_LED_PORT GPIOC
#define HB_LED_PIN GPIO_PIN_3

// Car State LEDs
#define DRIVABLE_LED_PORT GPIOC
#define DRIVABLE_LED_PIN GPIO_PIN_6

#define DRIVING_LED_PORT GPIOC
#define DRIVING_LED_PIN GPIO_PIN_9

#define CRUISE_LED_PORT GPIOB
#define CRUISE_LED_PIN GPIO_PIN_13

#define REGEN_LED_PORT GPIOB
#define REGEN_LED_PIN GPIO_PIN_15

#define BPS_FAULT_LED_PORT GPIOB
#define BPS_FAULT_LED_PIN GPIO_PIN_9

#define CAR_HB_LED_PORT GPIOB
#define CAR_HB_LED_PIN GPIO_PIN_14

// Motor Contactor
#define MOTOR_SENSE_TO_LED_PORT GPIOC
#define MOTOR_SENSE_TO_LED_PIN GPIO_PIN_7

#define MOTOR_ENABLE_LED_PORT GPIOC
#define MOTOR_ENABLE_LED_PIN GPIO_PIN_0

#define MOTOR_SENSE_LED_PORT GPIOC
#define MOTOR_SENSE_LED_PIN GPIO_PIN_2

// Precharge Contactor
#define PRECHARGE_COMPLETE_LED_PORT GPIOC
#define PRECHARGE_COMPLETE_LED_PIN GPIO_PIN_8

#define PRECHARGE_TO_LED_PORT GPIOD
#define PRECHARGE_TO_LED_PIN GPIO_PIN_2

#define PRECHARGE_SENSE_TO_LED_PORT GPIOC
#define PRECHARGE_SENSE_TO_LED_PIN GPIO_PIN_12

#define PRECHARGE_ENABLE_LED_PORT GPIOC
#define PRECHARGE_ENABLE_LED_PIN GPIO_PIN_4

#define PRECHARGE_SENSE_LED_PORT GPIOC
#define PRECHARGE_SENSE_LED_PIN GPIO_PIN_5

// Motor Faults
#define HALL_EFFECT_LED_PORT GPIOB
#define HALL_EFFECT_LED_PIN GPIO_PIN_3

#define DAWG_LED_PORT GPIOB
#define DAWG_LED_PIN GPIO_PIN_5

#define SWOC_LED_PORT GPIOA
#define SWOC_LED_PIN GPIO_PIN_10

#define FAULT_LED_PORT GPIOB
#define FAULT_LED_PIN GPIO_PIN_4

// SDCard Pins
#define SDCARD_CS_PORT      GPIOA
#define SDCARD_CS_PIN       GPIO_PIN_4

#define SDCARD_SCK_PORT      GPIOA
#define SDCARD_SCK_PIN       GPIO_PIN_5

#define SDCARD_MISO_PORT     GPIOA
#define SDCARD_MISO_PIN      GPIO_PIN_6

#define SDCARD_MOSI_PORT     GPIOA
#define SDCARD_MOSI_PIN      GPIO_PIN_7

// Other pins
#define USART3_PORT GPIOC
#define USART3_TX_PIN GPIO_PIN_10
#define USART3_RX_PIN GPIO_PIN_11

#define GPIO_INIT_PORT GPIOC
#define GPIO_ONE_PIN GPIO_PIN_8
#define GPIO_TWO_PIN GPIO_PIN_12

#define ADC_PORT GPIOB
#define ADC1_PIN GPIO_PIN_12
#define ADC2_PIN GPIO_PIN_2


/**
 * @brief object that holds pin num and port of a GPIO pin
 */
typedef struct {
    GPIO_TypeDef* port; // e.g., GPIOA
    uint16_t      pin;  // e.g., GPIO_PIN_3
} GpioPin_t;

typedef enum {
    NORMAL = 0,   // We good
    EMERGENCY = 1  // We bad
} fault_state_t;
