lhr-solar/PS-VehicleControlUnit/Firmware/Drivers/Src/ADC_Motor_LUT.c

#include "ADC_Motor_LUT.h"

const uint32_t Motor_LUT[4096] = {
    0u, 0u, 0u, 0u, 0u, 0u, 0u, 0u,
    0u, 0u, 0u, 0u, 0u, 0u, 0u, 0u,
    0u, 0u, 0u, 0u, 0u, 83u, 167u, 250u,
    333u, 417u, 500u, 583u, 667u, 750u, 833u, 917u,
    1000u, 1083u, 1167u, 1250u, 1333u, 1417u, 1500u, 1583u,
    1667u, 1750u, 1833u, 1917u, 2000u, 2083u, 2167u, 2250u,
    2333u, 2417u, 2500u, 2583u, 2667u, 2750u, 2833u, 2917u,
    3000u, 3083u, 3167u, 3250u, 3333u, 3417u, 3500u, 3583u,
    3667u, 3750u, 3833u, 3917u, 4000u, 4083u, 4167u, 4250u,
    4333u, 4417u, 4500u, 4583u, 4667u, 4750u, 4833u, 4917u,
    5000u, 5083u, 5167u, 5250u, 5333u, 5417u, 5500u, 5583u,
    5667u, 5750u, 5833u, 5917u, 6000u, 6083u, 6167u, 6250u,
    6333u, 6417u, 6500u, 6583u, 6667u, 6750u, 6833u, 6917u,
    7000u, 7083u, 7167u, 7250u, 7333u, 7417u, 7500u, 7583u,
    7667u, 7750u, 7833u, 7917u, 8000u, 8083u, 8167u, 8250u,
    8333u, 8417u, 8500u, 8583u, 8667u, 8750u, 8833u, 8917u,
    9000u, 9083u, 9167u, 9250u, 9333u, 9417u, 9500u, 9583u,
    9667u, 9750u, 9833u, 9917u, 10000u, 10083u, 10167u, 10250u,
    10333u, 10417u, 10500u, 10583u, 10667u, 10750u, 10833u, 10917u,
    11000u, 11083u, 11167u, 11250u, 11333u, 11417u, 11500u, 11583u,
    11667u, 11750u, 11833u, 11917u, 12000u, 12083u, 12167u, 12250u,
    12333u, 12417u, 12500u, 12583u, 12667u, 12750u, 12833u, 12917u,
    13000u, 13083u, 13167u, 13250u, 13333u, 13417u, 13500u, 13583u,
    13667u, 13750u, 13833u, 13917u, 14000u, 14083u, 14167u, 14250u,
    14333u, 14417u, 14500u, 14583u, 14667u, 14750u, 14833u, 14917u,
    15000u, 15083u, 15167u, 15250u, 15333u, 15417u, 15500u, 15583u,
    15667u, 15750u, 15833u, 15917u, 16000u, 16083u, 16167u, 16250u,
    16333u, 16417u, 16500u, 16583u, 16667u, 16750u, 16833u, 16917u,
    17000u, 17083u, 17167u, 17250u, 17333u, 17417u, 17500u, 17583u,
    17667u, 17750u, 17833u, 17917u, 18000u, 18083u, 18167u, 18250u,
    18333u, 18417u, 18500u, 18583u, 18667u, 18750u, 18833u, 18917u,
    19000u, 19083u, 19167u, 19250u, 19333u, 19417u, 19500u, 19583u,
    19667u, 19750u, 19833u, 19917u, 20000u, 20083u, 20167u, 20250u,
    20333u, 20417u, 20500u, 20583u, 20667u, 20750u, 20833u, 20917u,
    21000u, 21083u, 21167u, 21250u, 21333u, 21417u, 21500u, 21583u,
    21667u, 21750u, 21833u, 21917u, 22000u, 22083u, 22167u, 22250u,
    22333u, 22417u, 22500u, 22583u, 22667u, 22750u, 22833u, 22917u,
    23000u, 23083u, 23167u, 23250u, 23333u, 23417u, 23500u, 23583u,
    23667u, 23750u, 23833u, 23917u, 24000u, 24083u, 24167u, 24250u,
    24333u, 24417u, 24500u, 24583u, 24667u, 24750u, 24833u, 24917u,
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
