lhr-solar/PS-VehicleControlUnit/Firmware/Tasks/Inc/InitTask.h

#pragma once

#include "FaultHandlerTask.h"
#include "PrechargeTask.h"
#include "VCUReceiveCANTask.h"
#include "DriverInputTask.h"
#include "MotorSafeBits.h"
#include "MotorControlTask.h"
#include "MotorTelemetryTask.h"
#include "CanTxTelemetryTask.h"
#include "CANbus.h"

#define INIT_TASK_STACK_SIZE                configMINIMAL_STACK_SIZE
#define FAULT_HANDLER_TASK_STACK_SIZE       configMINIMAL_STACK_SIZE
#define PRECHARGE_TASK_STACK_SIZE           configMINIMAL_STACK_SIZE
#define MOTOR_CONTROL_TASK_STACK_SIZE       configMINIMAL_STACK_SIZE
#define MOTOR_TELEMETRY_TASK_STACK_SIZE     configMINIMAL_STACK_SIZE
#define CAN_TX_TELEMETRY_STACK_SIZE         configMINIMAL_STACK_SIZE


extern StaticTask_t FaultHandlerTask_Buffer;
extern StackType_t FaultHandlerTask_Stack[FAULT_HANDLER_TASK_STACK_SIZE];

extern StaticTask_t Precharge_Task_Buffer;
extern StackType_t Precharge_Task_Stack[PRECHARGE_TASK_STACK_SIZE];

extern StaticTask_t Init_Task_Buffer;
extern StackType_t Init_Task_Stack[INIT_TASK_STACK_SIZE];

extern StaticTask_t Motor_Control_Task_Buffer;
extern StackType_t Motor_Control_Task_Stack[MOTOR_CONTROL_TASK_STACK_SIZE];

extern StaticTask_t Motor_Telemetry_Task_Buffer;
extern StackType_t Motor_Telemetry_Task_Stack[MOTOR_TELEMETRY_TASK_STACK_SIZE];

extern StaticTask_t Can_Tx_Telemetry_Task_Buffer;
extern StackType_t Can_Tx_Telemetry_Task_Stack[CAN_TX_TELEMETRY_STACK_SIZE];

#define FAULT_HANDLER_THREAD_PRIO       (tskIDLE_PRIORITY + 4)
#define PRECHARGE_THREAD_PRIO           (tskIDLE_PRIORITY + 3)
#define MOTOR_CONTROL_THREAD_PRIO       (tskIDLE_PRIORITY + 2)
#define MOTOR_TELEMETRY_THREAD_PRIO     (tskIDLE_PRIORITY + 1)
#define CAN_TX_TELEMETRY_THREAD_PRIO    (tskIDLE_PRIORITY + 1)
#define SDCARD_WORKER_THREAD_PRIO       (tskIDLE_PRIORITY + 1)

// Period the fault thread runs at (once a fault is active)
#define FAULT_LOOP_PERIOD_MS 500

// Period the motor control thread runs at
#define MOTOR_CONTROL_TASK_PERIOD_MS 100

// Period the precharge thread runs at 
#define PRECHARGE_TASK_DELAY_MS 100


extern StaticTask_t VCUReceiveCAN_Task_Buffer;
extern StackType_t VCUReceiveCAN_Task_Stack[configMINIMAL_STACK_SIZE];

void Task_Init();
