lhr-solar/PS-VehicleControlUnit/Firmware/Drivers/Src/FaultBits.c

#include "FaultBits.h"

// Event group handle to store fault state bits
EventGroupHandle_t faultStateBits;
EventGroupHandle_t stateBits;

// Static buffer to store the event handle
StaticEventGroup_t faultStateBitsBuffer;
StaticEventGroup_t stateBitsBuffer;

uint8_t faultBits_init(void){
    faultStateBits = xEventGroupCreateStatic( &faultStateBitsBuffer );
    if(faultStateBits == NULL){
        return 0;
    }
    return 1;
}

void set_faultBit(fault_bit_t bit){
    // not a valid fault
    if(bit >= NUM_FAULTS){ 
        return;
    }

    // chat we're cooked
    xEventGroupSetBits(faultStateBits, FAULT_BIT(bit));
    // should never return from here
    taskYIELD();
}

void set_faultBitFromISR(fault_bit_t bit){
    BaseType_t xHigherPriorityTaskWoken = pdFALSE;

    if(bit >= NUM_FAULTS){
        return;
    }

    xEventGroupSetBitsFromISR(
        faultStateBits,
        FAULT_BIT(bit),
        &xHigherPriorityTaskWoken
    );

    portYIELD_FROM_ISR(xHigherPriorityTaskWoken);
}

uint8_t stateBits_init(void){
    stateBits = xEventGroupCreateStatic( &stateBitsBuffer );
    if(stateBits == NULL){
        return 0;
    }
    return 1;
}

void set_stateBit(state_bit_t bit){
    // not a valid state    
    if(bit >= NUM_STATES){ 
        return;
    }

    // Clear all state bits first
    xEventGroupClearBits(stateBits, STATE_BITMASK);

    // Set only the requested bit
    xEventGroupSetBits(stateBits, STATE_BIT(bit));

    taskYIELD();
}

EventBits_t faultBit_wait(fault_bit_t bit, TickType_t xTicksToWait){

    // NUM_FAULTS indiciates you want to wait for all bits
    if(bit > NUM_FAULTS){
        return 0;
    }

    EventBits_t uxBitsToWaitFor = bit == NUM_FAULTS ? FAULT_BITMASK : (FAULT_BIT(bit));

    EventBits_t pending = xEventGroupWaitBits(
        faultStateBits,
        uxBitsToWaitFor,  // wait for any defined fault
        pdFALSE,          // fault bits are not reset
        pdFALSE,          // wait for ANY bit to be set
        xTicksToWait 
    );
    return pending;
}
