lhr-solar/PS-VehicleControlUnit/Firmware/Tasks/Inc/FaultHandlerTask.h

#pragma once

#include "FaultBits.h"
#include "StatusLEDs.h"
#include "Contactors.h"
#include "task.h"
#include "InitTask.h"
#include "CANbus.h"
#include "CarCAN_can_msgs.h"
#include "MotorSafeBits.h"

#define MAX_FAULT_STRING_CHARS 20
#define PRINTF_DELAY_MS 250

typedef struct{
    const char fault_string[MAX_FAULT_STRING_CHARS];
    uint8_t faultStringSize;
}fault_string_t;


/** @brief Initialize the fault handler task. */
void Init_FaultHandlerTask();

/** @brief Run the fault handler task. */
void Task_FaultHandler();

/** @brief Kill the precharge task. */
void Kill_Precharge_Task();

void Fault_Loop();

void Set_Fault_LED();

extern EventBits_t fault_bits;
extern EventBits_t state_bits;
