lhr-solar/PS-VehicleControlUnit/Firmware/Tasks/Inc/PrechargeTask.h

#pragma once

#include "FaultBits.h"
#include "Contactors.h"
#include "StatusLEDs.h"
#include "ADC_Sense.h"
#include "InitTask.h"
#include "MotorSafeBits.h"
#include "CANbus.h"
#include "CarCAN_can_msgs.h"
#include <string.h>
#include "VCUReceiveCANTask.h"

// Precharge thresholds
#define OVERVOLTAGE_THRESHOLD_MV 140000 // 140 V
#define UNDERVOLTAGE_THRESHOLD_MV 80000 // 80.0 V

// Fixed-point scaling for ratio comparisons
#define RATIO_SCALE 1000

// 900/1000 = 0.900, 800/1000 = 0.800
// TODO: Test and increase hysterisis threshold closer to 90%
#define PRECHARGE_THRESHOLD_90 900
#define PRECHARGE_THRESHOLD_80 800 // NOTE: The second threshold exists to account for hysteresis, so that we don't drop out of the run state after successfully precharging just because of a small ADC reading change

// Allowed difference between motor and battery voltage
#define VOLTAGE_TOLERANCE_NUMERATOR 22
#define VOLTAGE_TOLERANCE_DENOMINATOR 20 // Motor voltage can at most 10% higher than battery voltage

#define PRECHARGE_TIMEOUT_MS 400 // Precharge time to 90% -> 0.9 = 1 - e^(-t/RC), so t = -RC * ln(1-0.9) = 2.3*RC. For our case, R = 110 Ohms and C = 1 mF -> t = 253 ms.
#define ADC_TIMEOUT_MS 20

typedef enum
{
    PRECHARGE_STATE_WAITING, // Waiting for ignition state
    PRECHARGE_STATE_INITIAL, // Precharge sequence hasn't started, start by closing main contactor and starting a timer to check for precharge timeout
    PRECHARGE_STATE_PRECHARGING, // Precharge sequence started successfully, close contactor and check hysterisis
    PRECHARGE_STATE_RUN,          // Precharge got through hysterisis, now continuously polling ADC
    PRECHARGE_STATE_NUM
} Precharge_State_t;

/**
 * @brief Precharge task initialization function, initializes ADC, printf, and contactors
 * @param None
 * @retval None
 */
void Init_PrechargeTask();

/**
 * @brief Checks the repeated fault conditions for precharge sequence, if any fault condition is met, will call fault handler and not return
 * @param Motor_Voltage most recent motor voltage reading in mV
 * @param Battery_Voltage most recent battery voltage reading in mV
 * @retval None
 */
void Fault_Checker(uint32_t Motor_Voltage, uint32_t Battery_Voltage);

/**
 * @brief Precharge task main execution function, implements precharge pseudo state machine and fault handling
 * @param None
 * @retval None
 */
void Task_Precharge();

void Ignition_Off();

/* handle for the Precharge task, defined in PrechargeTask.c */
extern TaskHandle_t hprecharge_task;

extern uint32_t Battery_Voltage;
extern uint32_t Motor_Voltage;
extern uint8_t Ignition_State;
