lhr-solar/PS-VehicleControlUnit/Firmware/Drivers/Inc/ESP32.h

#pragma once
#include "FreeRTOS.h"
#include "stm32xx_hal.h"
#include "UART.h"
#include "UART_Init.h"

uart_status_t ESP32_UART_Init(void);

uart_status_t ESP32_Send(const uint8_t* data, uint8_t length, TickType_t delay_ticks);

uart_status_t ESP32_Recv(uint8_t* data, uint8_t length, TickType_t delay_ticks);
