lhr-solar/PS-VehicleControlUnit/(commit log)

2025-09-12 RevA (#1)
    * blank VCU sch
    * fix
    * inital sch
    * sch additions
    * initial commit post VCU block diagram
    * alsdkjf
    * sch for review missing LSOM
    * add lsom sym
    * pOSPAOBJCO
    * review LSOM
    * review sch one last time
    * added opto's to sense signals
    * layout start
    * first revision
    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
    [436500227.stp, 436500428.stp, ActivePrecharge.kicad_sch, Buttond_LEDs_IO.kicad_sch, CAN.kicad_sch, ContactorDriver.kicad_sch, ESP.kicad_sch, HVArchitecture.kicad_sch]
2026-01-13 Rev B (#2)
    * tweaking
    * fixed
    * review changes
    * is it time to give up :3
    * minor fixes
    * 24v changes
    * moving to kicad-bild
    * fuck the rats nest im doing it tomorrow
    * routing done
    * replace microfit with nanofit and some layout adjustments
    * lakshay nitpicks
    * shrunk the board by 7mm
    * cubemx stuff
    * Add files via upload
    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
    [436500227.stp, 436500428.stp, ActivePrecharge.kicad_sch, Buttond_LEDs_IO.kicad_sch, CAN.kicad_sch, ContactorDriver.kicad_sch, ESP.kicad_sch, HVArchitecture.kicad_sch]
2026-01-14 Firmware Setup (#3)
    * compiling code
    * change name of tests
    * add instructions
    * clarify firmware in firmware/ dir
    * spell exclusing correctly
    * add workflow
    * move workflow to correct folder
    * init submodule in workflow
    * fix embedded-sharepoint submodule
    * womp womp
    * kms
    * prepare urself ravi
    * a
    * tony doesn't understand how directories work
    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
    [blinky_test.c, main.c, main_test.c, pinDefs.h]
2026-01-29 Fix build action (#6)
    * fix build actions cript
    * add production test file
    [makeAllTests.py]
2026-03-05 Precharge and MotorCAN drivers (#5)
    * First few bits of firmware, copy pasted the ADC and clock stuff and wrote the read function and outlined precharge logic
    * Created driver folders and moved stuff out of main, rewrote to use fixed point instead of floating
    * All comments addressed, plus wrote h files for the new stuff I created
    * Everything except VCU pins and contactor stuff has been done, the test is prob some garbage, how makefile so i can build and fix errors
    * comments addressed plus led blinking code
    * fixed some build issues
    * fixed pins
    * workday
    * refactored everything so that it compiles
    * update embedded sharepoint
    * Created a inits c/h file, moved around a lot of ini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
    [ADC_Motor_LUT.c, ADC_Sense.c, ADC_Sense.h, CANBus_test.c, CANbus.c, CANbus.h, Contactors.c]
2026-03-11 Precharge + Motor Control Integration (#10)
    * balls
    * integrated motor telemetry and control in main
    * balls
    * balls
    * gem en eye
    * fix build for motor controller test
    * made a bunch of changes and now nothing work :(
    * build action only runs on push
    * balls
    * add defines for stack size
    * balls
    * prat brought back chungus
    * balls
    * add fault string struct
    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
    [CANbus.c, CANbus.h, CanTxTelemetryTask.c, CanTxTelemetryTask.h, CanTxTelemetry_test.c, Contactors.c, Contactors_test.c, FaultHandlerTask.c]
2026-03-11 ESP32 Drivers (#9)
    * started shell driver
    * reorganize UART init and add ESP32 init
    * added adc read to esp32_test
    * sends but doubled
    * working but bad
    * skeletonizing code to restart
    * storing for now before lakshay breaks my code
    * working
    * tony (gavin) chen
    * dumba
    * tony i swear to god
    ---------
    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
2026-04-11 precharge integration (#13)
    * Testing sending CAN messages for precharge voltages and VCU status should be ready. I changed FaultBits so that precharge states are now in a new enum state_bit_t. According changes have been made to PrechargeTask but it all needs to be tested to make sure it still works because FaultBits no longer has to cut off the first 3 bits which were previously the state bits.
    * Added the CarCAN messages file, forgot the first time
    * Caught one setFaultBit call that hadn't been changed to setStateBit. Precharge sequence now works again. Moving on to CAN.
    * Made tests for CAN
    * Fix build
    * Build work frfr
    * Implemented so called schizo CAN test
    * fuckass can bs
    * C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
    [CANBus_test.c, CANbus.c, CANbus.h, CanTxTelemetry_test.c, CarCAN_can_msgs.h, Contactors.h, DriverInputTask.c, DriverInputTask.h]
